nikosmitro/telecover4/20190409_133329.jpg

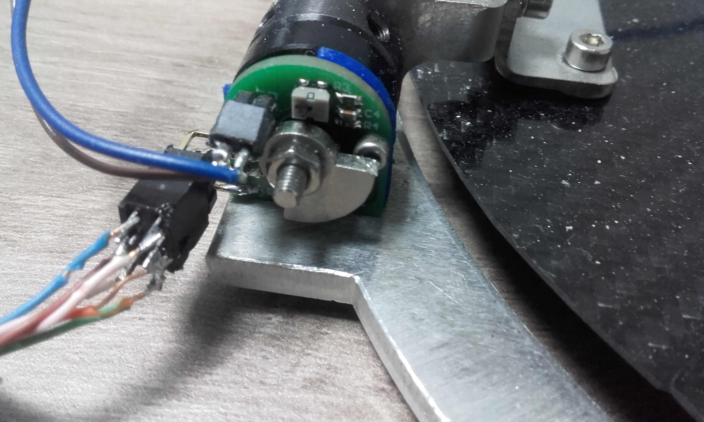
20190409_133329.jpg
