nikosmitro/telecover4/20190409_114414.jpg

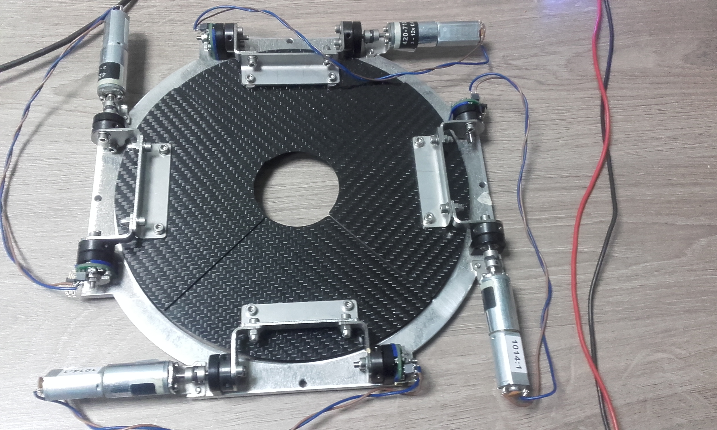
20190409_114414.jpg
