nikosmitro/telecover4/README.md

# telecover4

Programming an Arduino Leonardo to control a four motor Telecover. 

The telecover is placed in front of the laser "cannon" of a 3D scanning LIDAR (LIght Detection And Ranging). 

The code is written in Arduino studio.
