nikosmitro/telecover4/20190409_114408.jpg

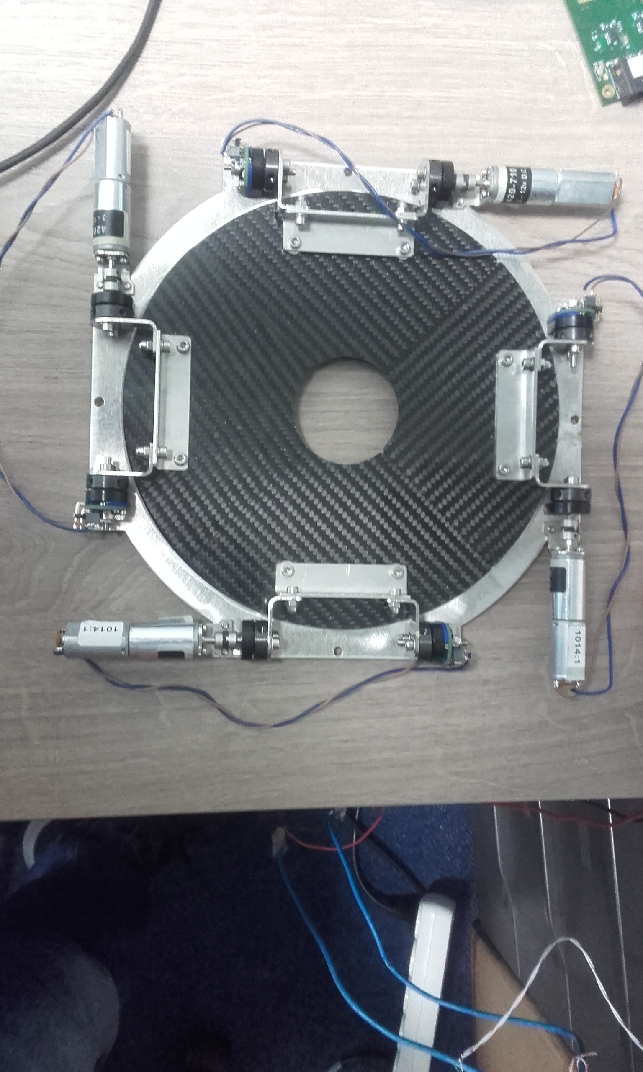
20190409_114408.jpg
