nikosmitro/telecover4/20190409_114425.jpg

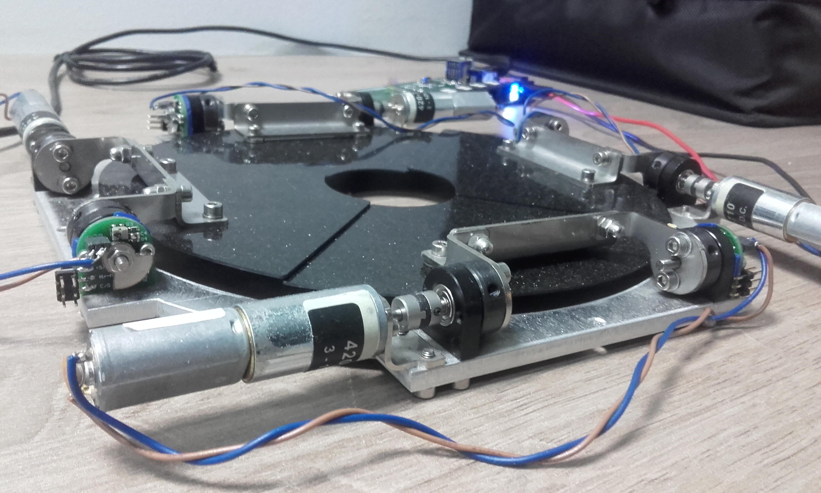
20190409_114425.jpg
