nikosmitro/telecover4/20190409_124950.jpg

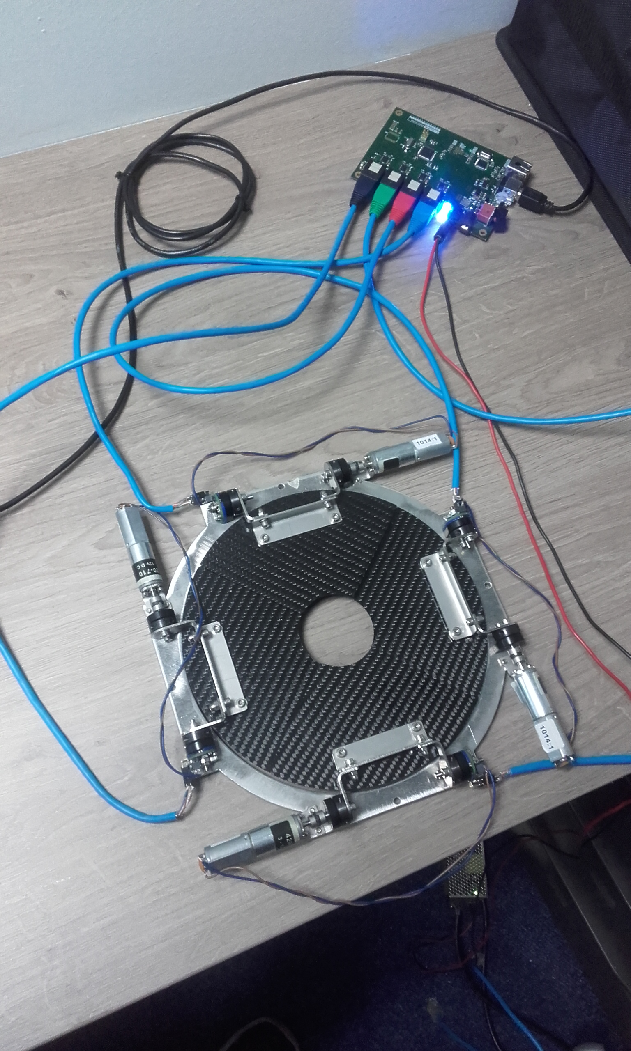
20190409_124950.jpg
