nikosmitro/telecover4/20190409_130513.jpg

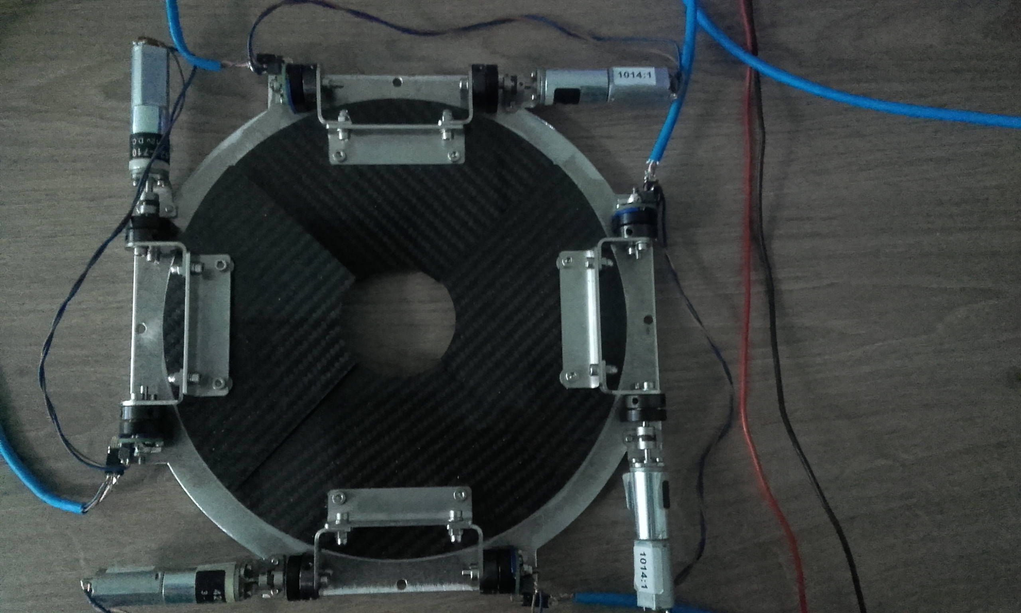
20190409_130513.jpg
