nikosmitro/telecover4/20190409_133322.jpg

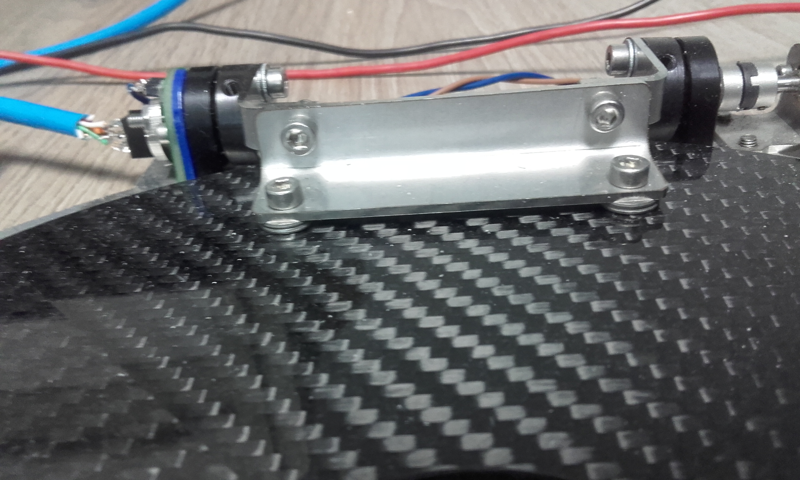
20190409_133322.jpg
