nikosmitro/telecover4/Telecover Motor.pdf

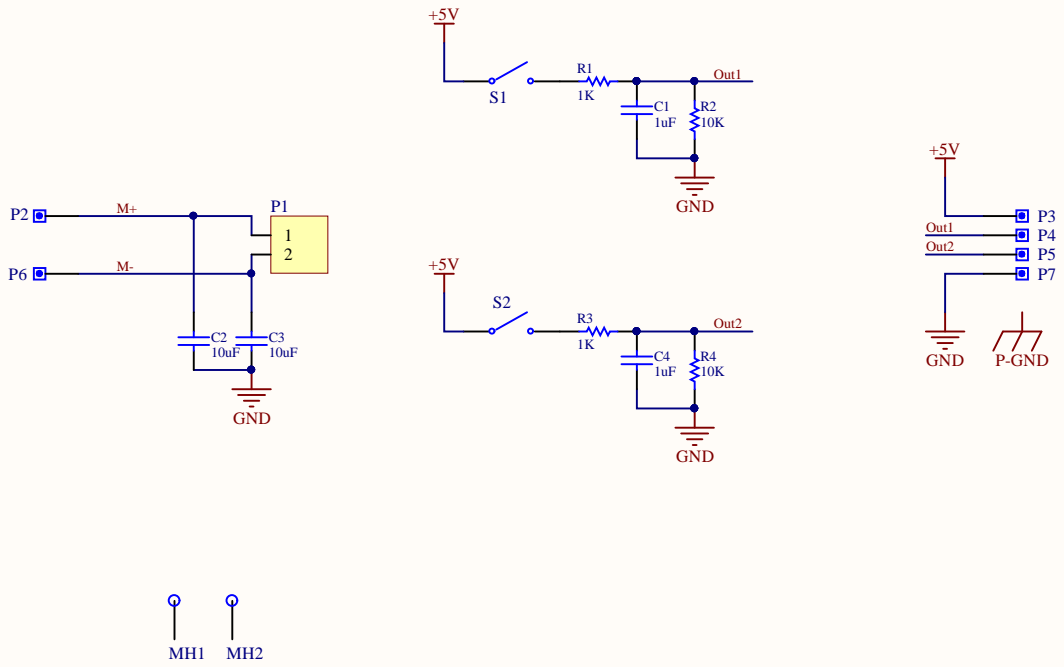
[picture p14: page 1]

Project : ATC4 0 0 | Raymetr ics Sp a r t i s 3 2 1 4 4 5 2 Met a m o rfo s i s A t hen s, G reece

T i t le: Switc h e s | Ver : 0 1
Draw i n g : - | Rev : A
Part N umber: 0 0 3 6 A TC0 1 A 0 1 1 8 | Size: A 4
Date: 2 3 / 0 1 / 2 0 1 8 Mo d ified Date: 2 3 / 1 / 2 0 1 8 | Sheet 1 o f 1 | E n g i neer: Trian tafi l l i d i s

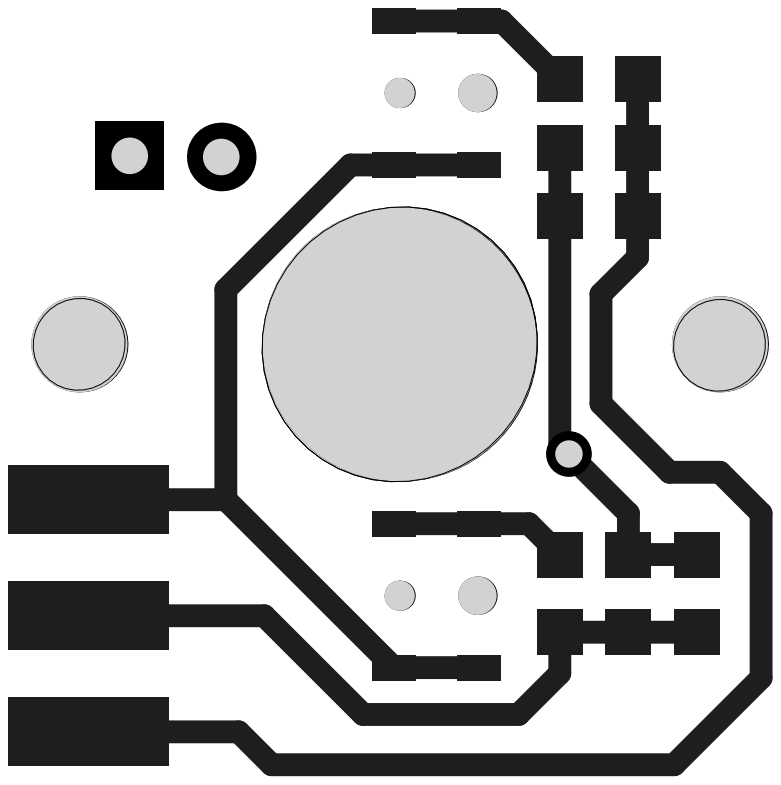
[picture p15: page 2]

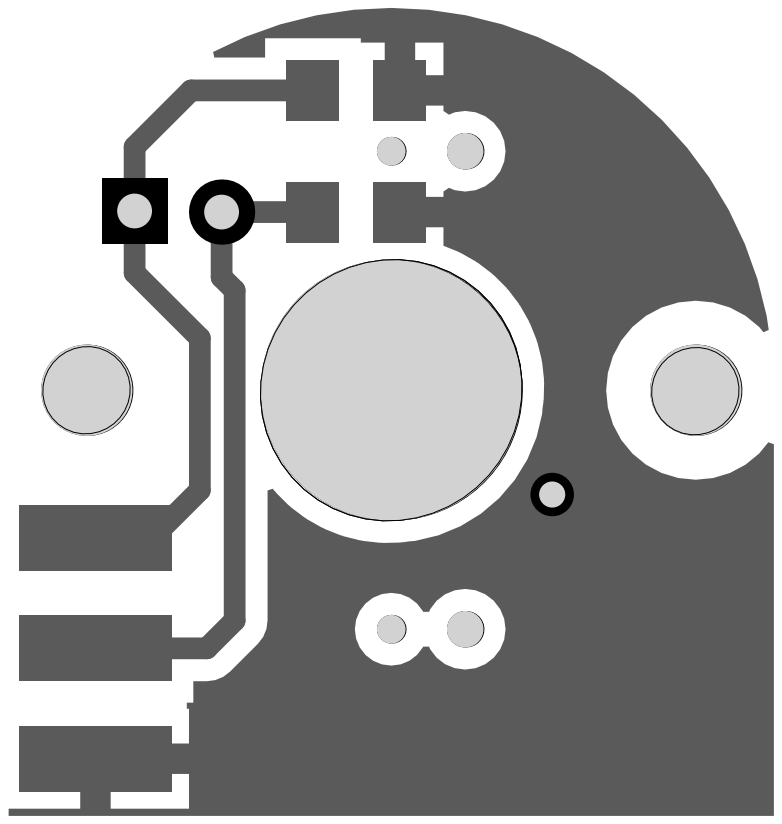
[picture p16: page 3]

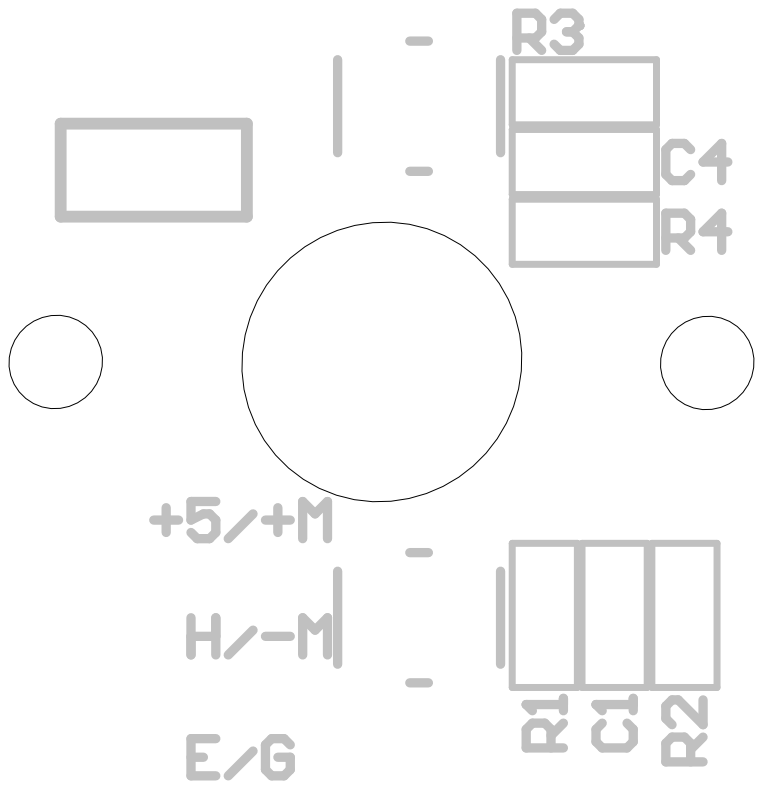
[picture p17: page 4]

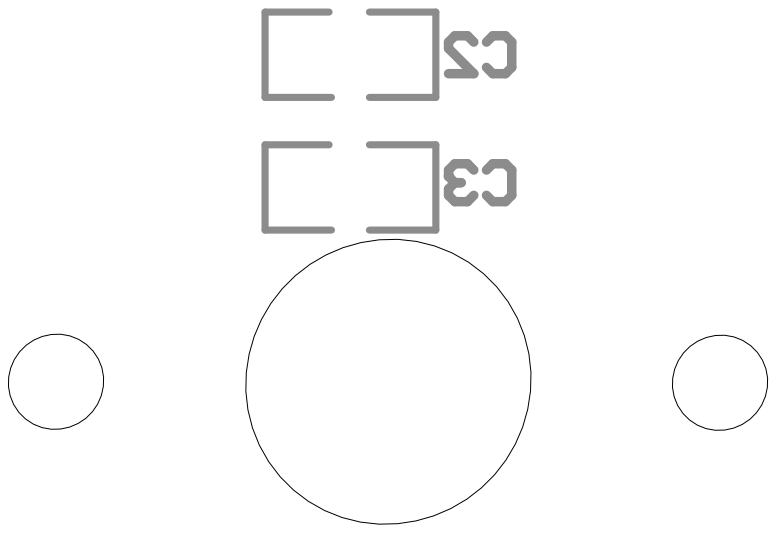
[picture p18: page 5]

# Switches

### ATC400

### 0036ATC01A0118

### Raymetrics

| Report Date: 25/2/2019 | | 10:46:06 πμ
| Print Date / Time: 25/2/19 10:46
Column Name E | Part Type | Description | Value | Case | Manufacturer | Part Number | Quantity | Farnell | Mouser | RS
Capacitor | 35V, ±10%, X5R | 10uF | 0805 | MURATA | GRM21BR6YA106KE3L | 2 | 2611943 | 81-GRM21BR6YA106KE3L | 7900673
Capacitor | MLCC, 50Vdc, +85°C, X5R, ±10% | 1uF | 0603 | TDK | C1608X5R1H105K080AB | 2 | 2211179 | 810-C1608X5R1H105K | 7883001
Header | Header, 2-Pin | | | | | 1
Header | Plug | | | | | 6
Resistor | ±1%, 200mW, 50V, ±100ppm/K | 1K | 0603 | TE | CRGH0603F1K0 | 2 | 2332003 | | 8075380
Resistor | ±1%, 200mW, 50V, ±100ppm/K | 10K | 0603 | TE | CRGH0603F10K | 2 | 2332016 | | 8075364
Sw itch | Sw itch, Detect, 4Leads, 5V, 1mA | | | C&K | HDT0001 | 2 | 9575154 | 611-HDT0001 | 7931598
Approved | Notes: | 17

## Component list

### Project:

### Part Number:

### Company:
